trlafleur/Sensor1/IMG_2805.JPG

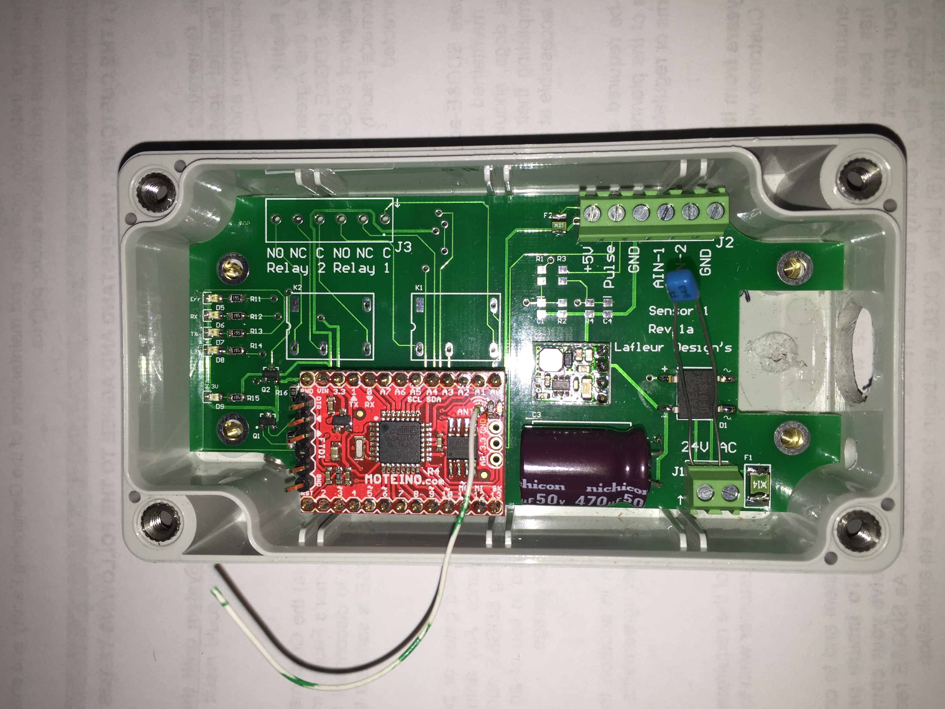
IMG_2805.JPG
