trlafleur/Sensor1/IMG_2804.JPG

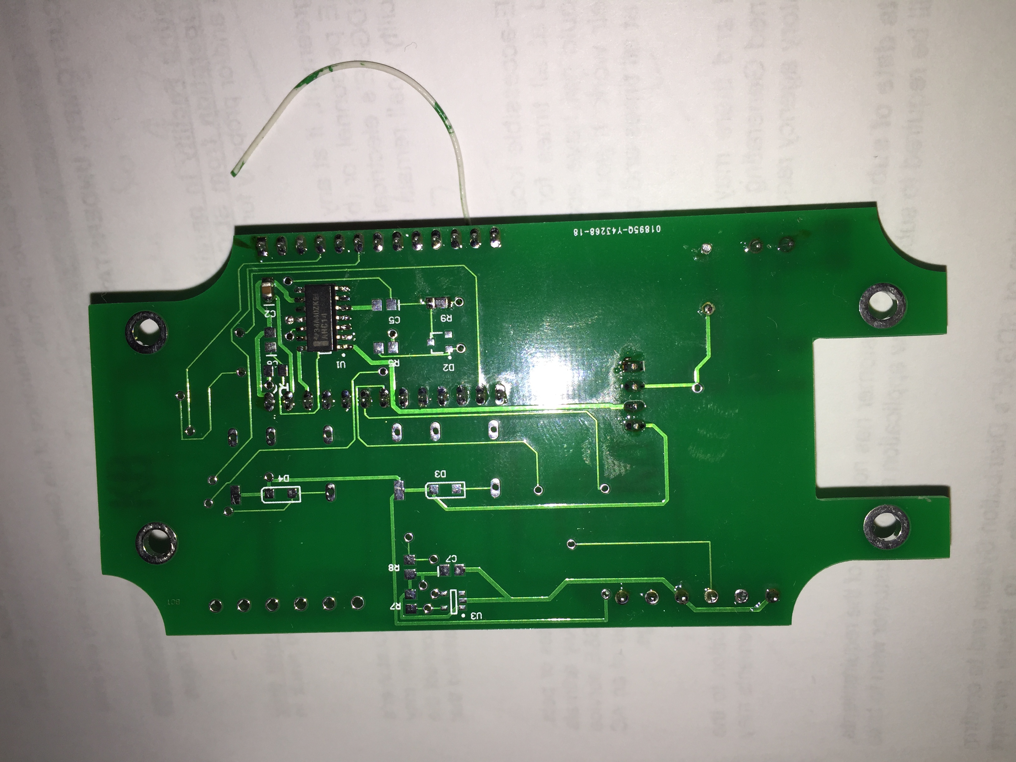
IMG_2804.JPG
