trlafleur/Sensor1/IMG_3028.JPG

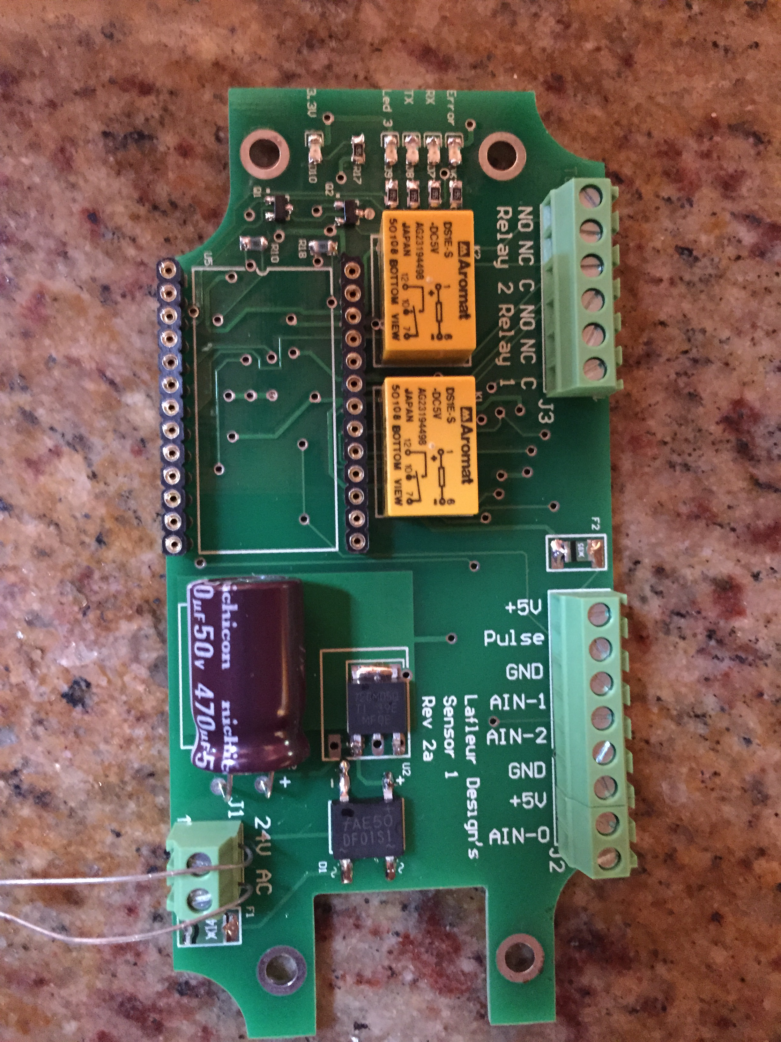
IMG_3028.JPG
