trlafleur/Sensor1/IMG_3032.JPG

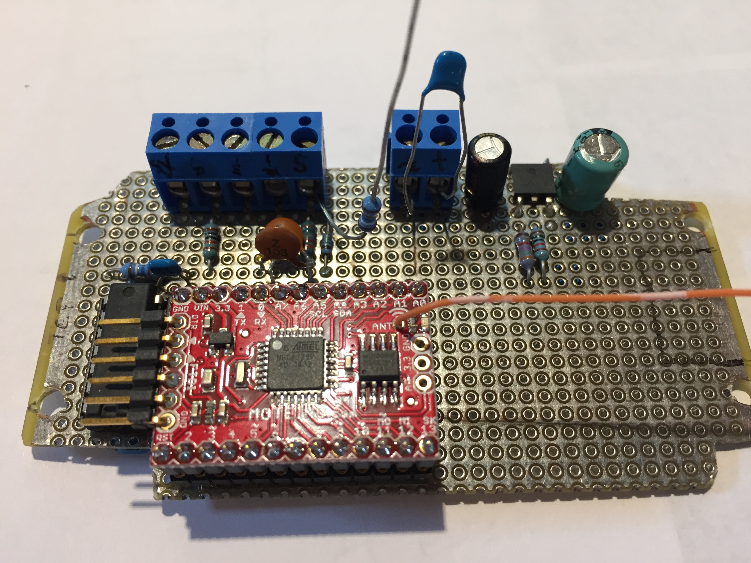
IMG_3032.JPG
