trlafleur/Sensor1/IMG_3034.JPG

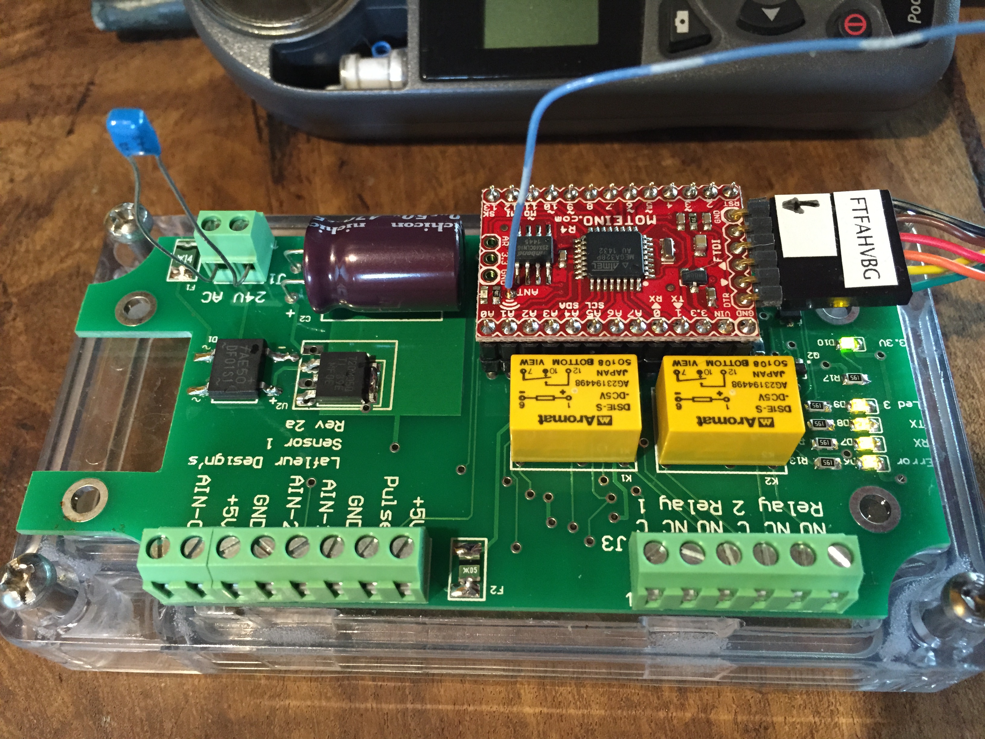
IMG_3034.JPG
