trlafleur/Sensor1/IMG_3035.JPG

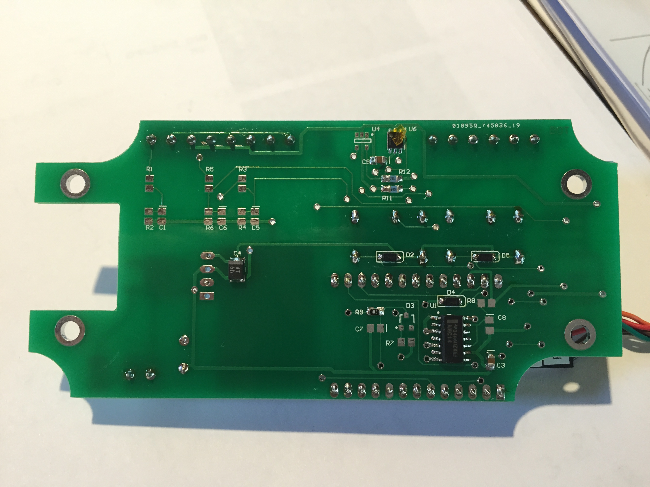
IMG_3035.JPG
