trlafleur/Sensor1/WaterSensor Rev-2a.pdf

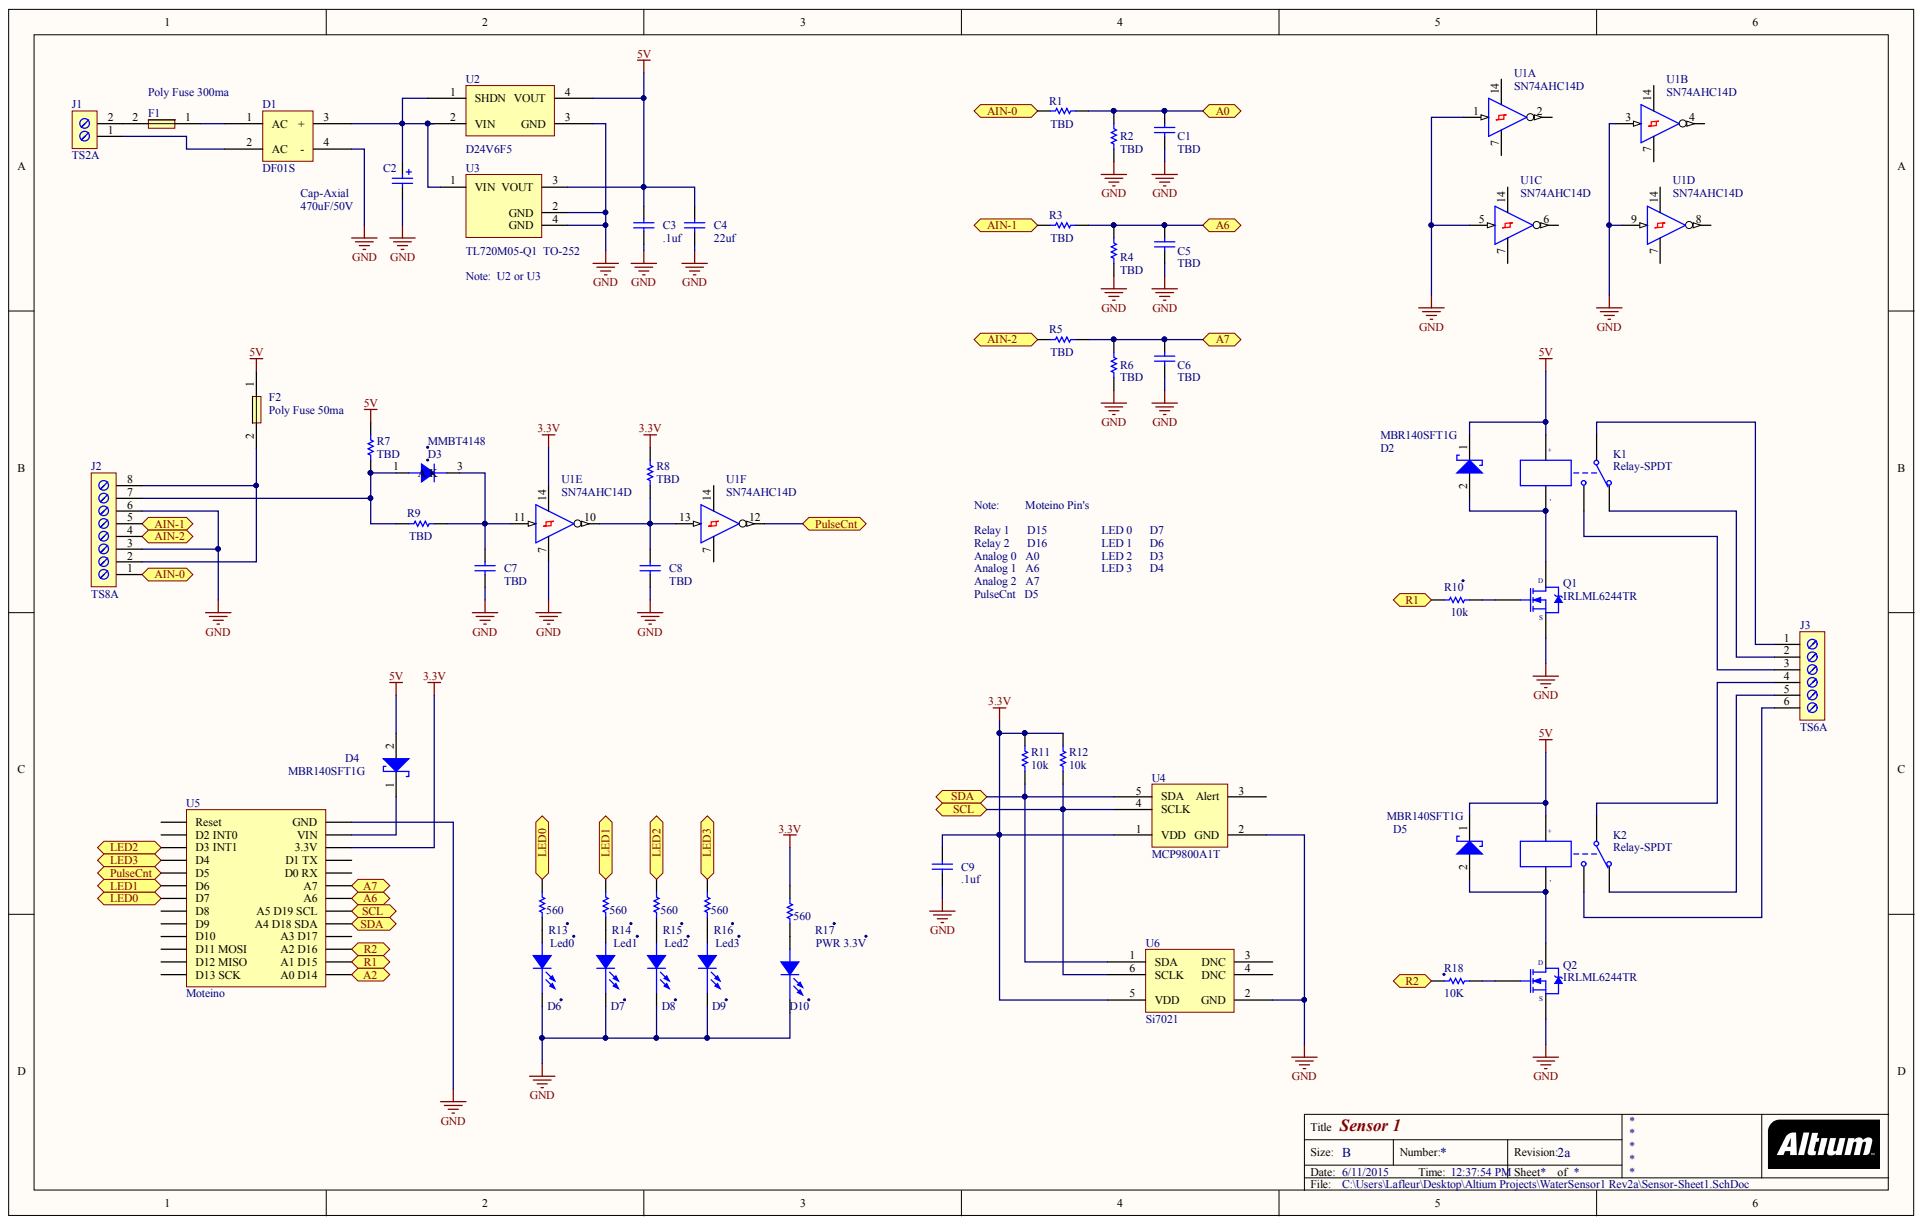
[picture p7: page 1]

Size: B | Number : * | Revi s ion: 2 a
Date: T i me: | | Sheet * of *
Fi le: s \WaterSensor1 Rev2a\Sensor -Sheet1.SchDoc

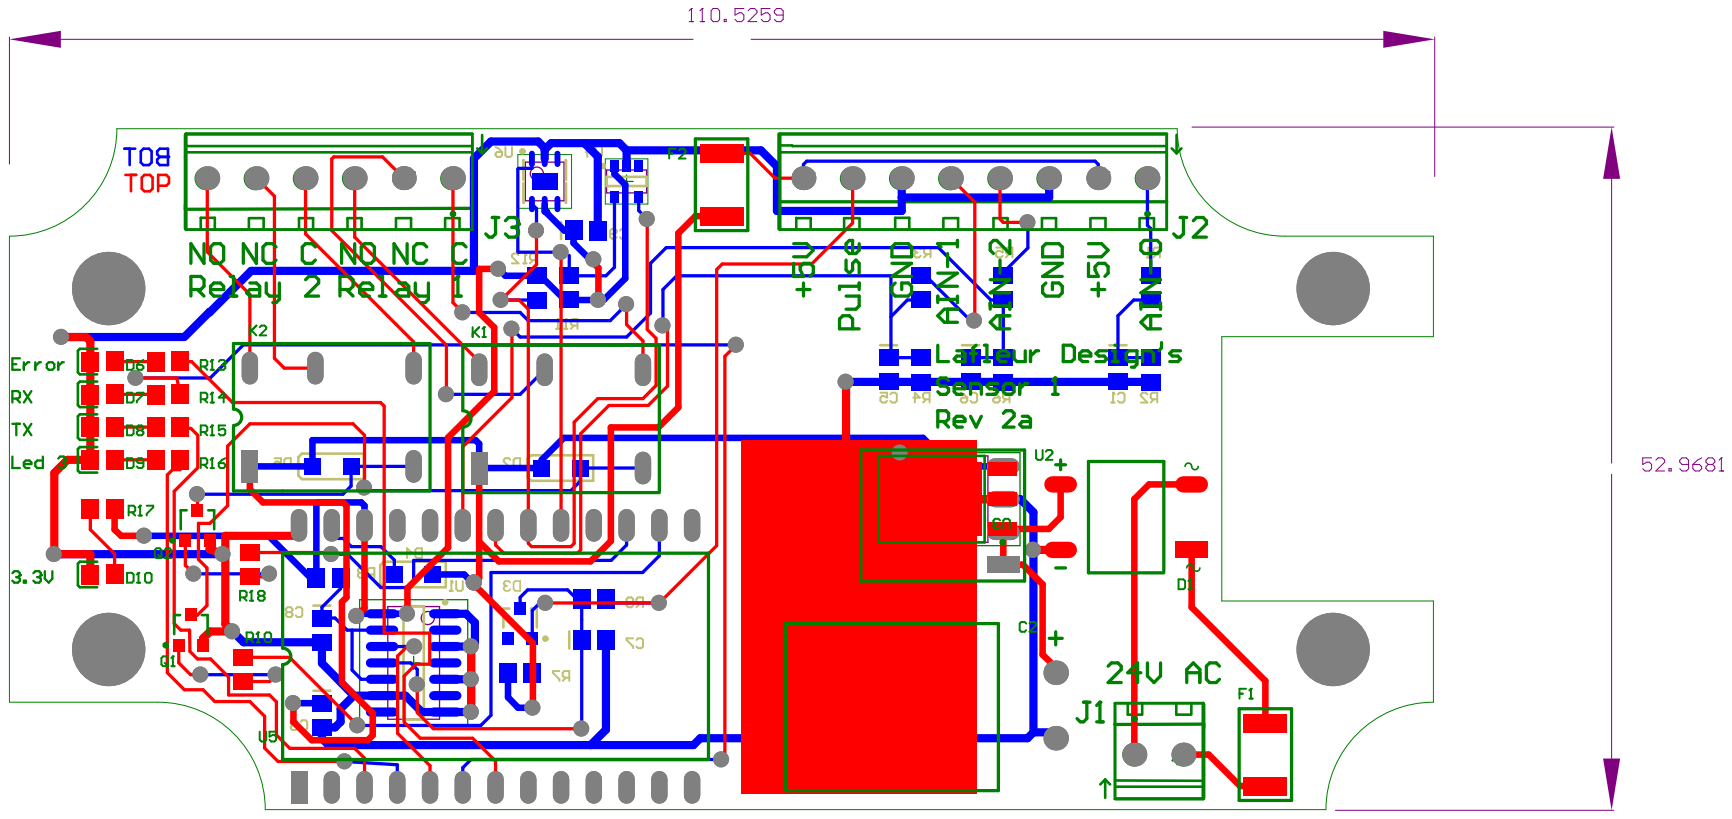
[picture p8: page 2]
